cracked-machine/PWMGEN/HW/PWMGEN/DOCS/PWMGEN.pdf

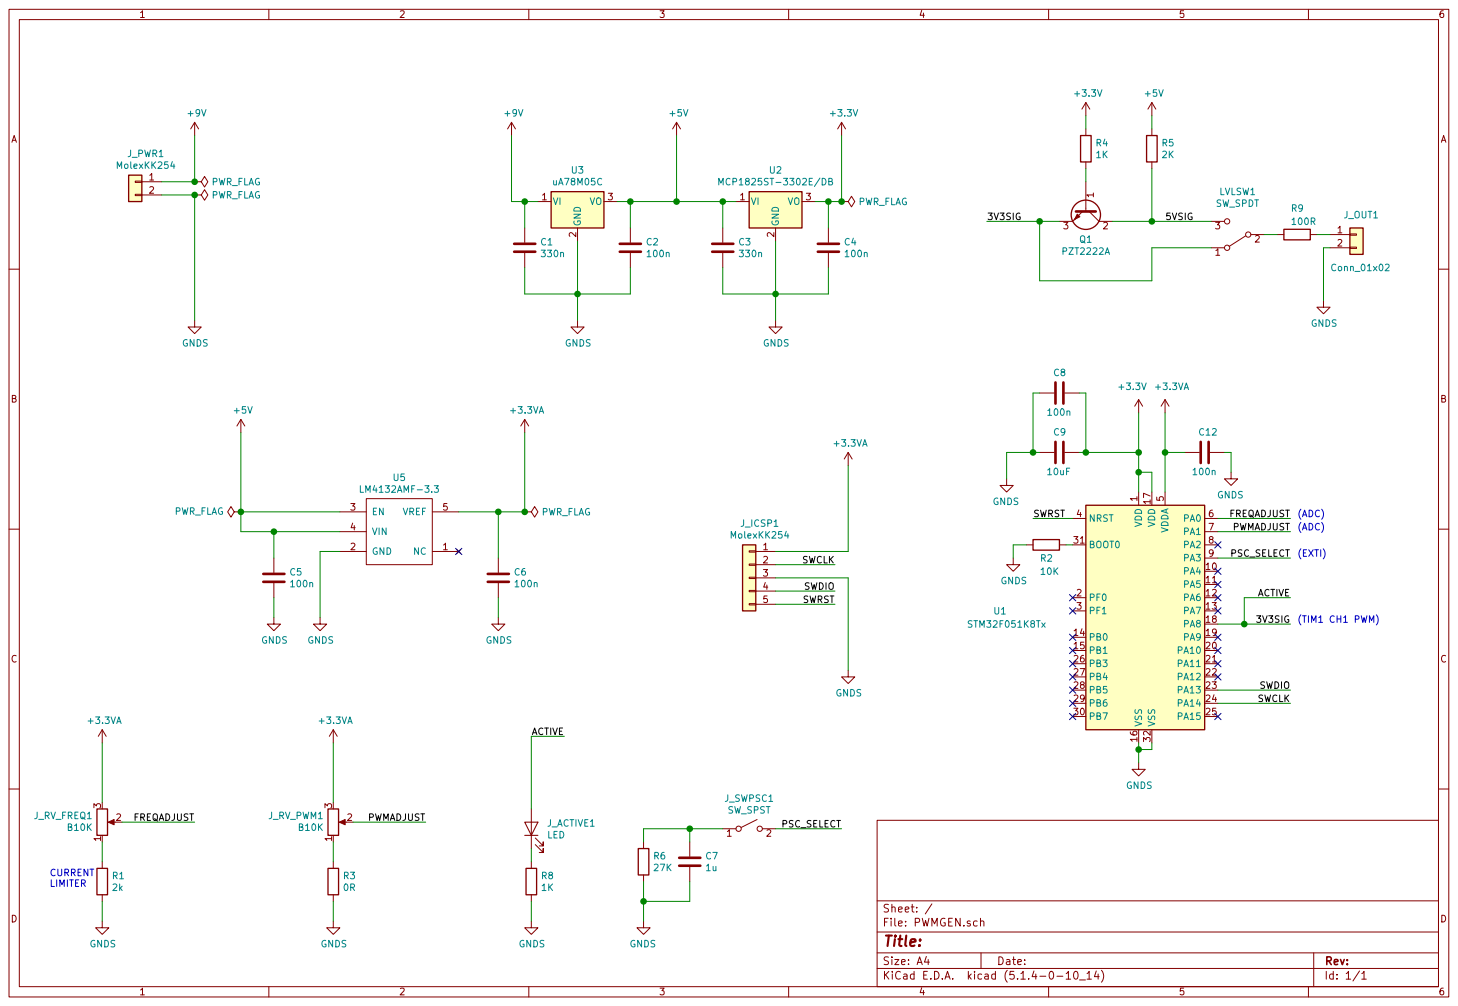
[picture p1: page 1]

Id: 1/1 Title: File: PWMGEN.sch Sheet: /
