cracked-machine/PWMGEN/HW/PWMGEN/PWMGEN.kicad_pcb

## KiCad design HW/PWMGEN/PWMGEN.kicad_pcb (2019-10-10)

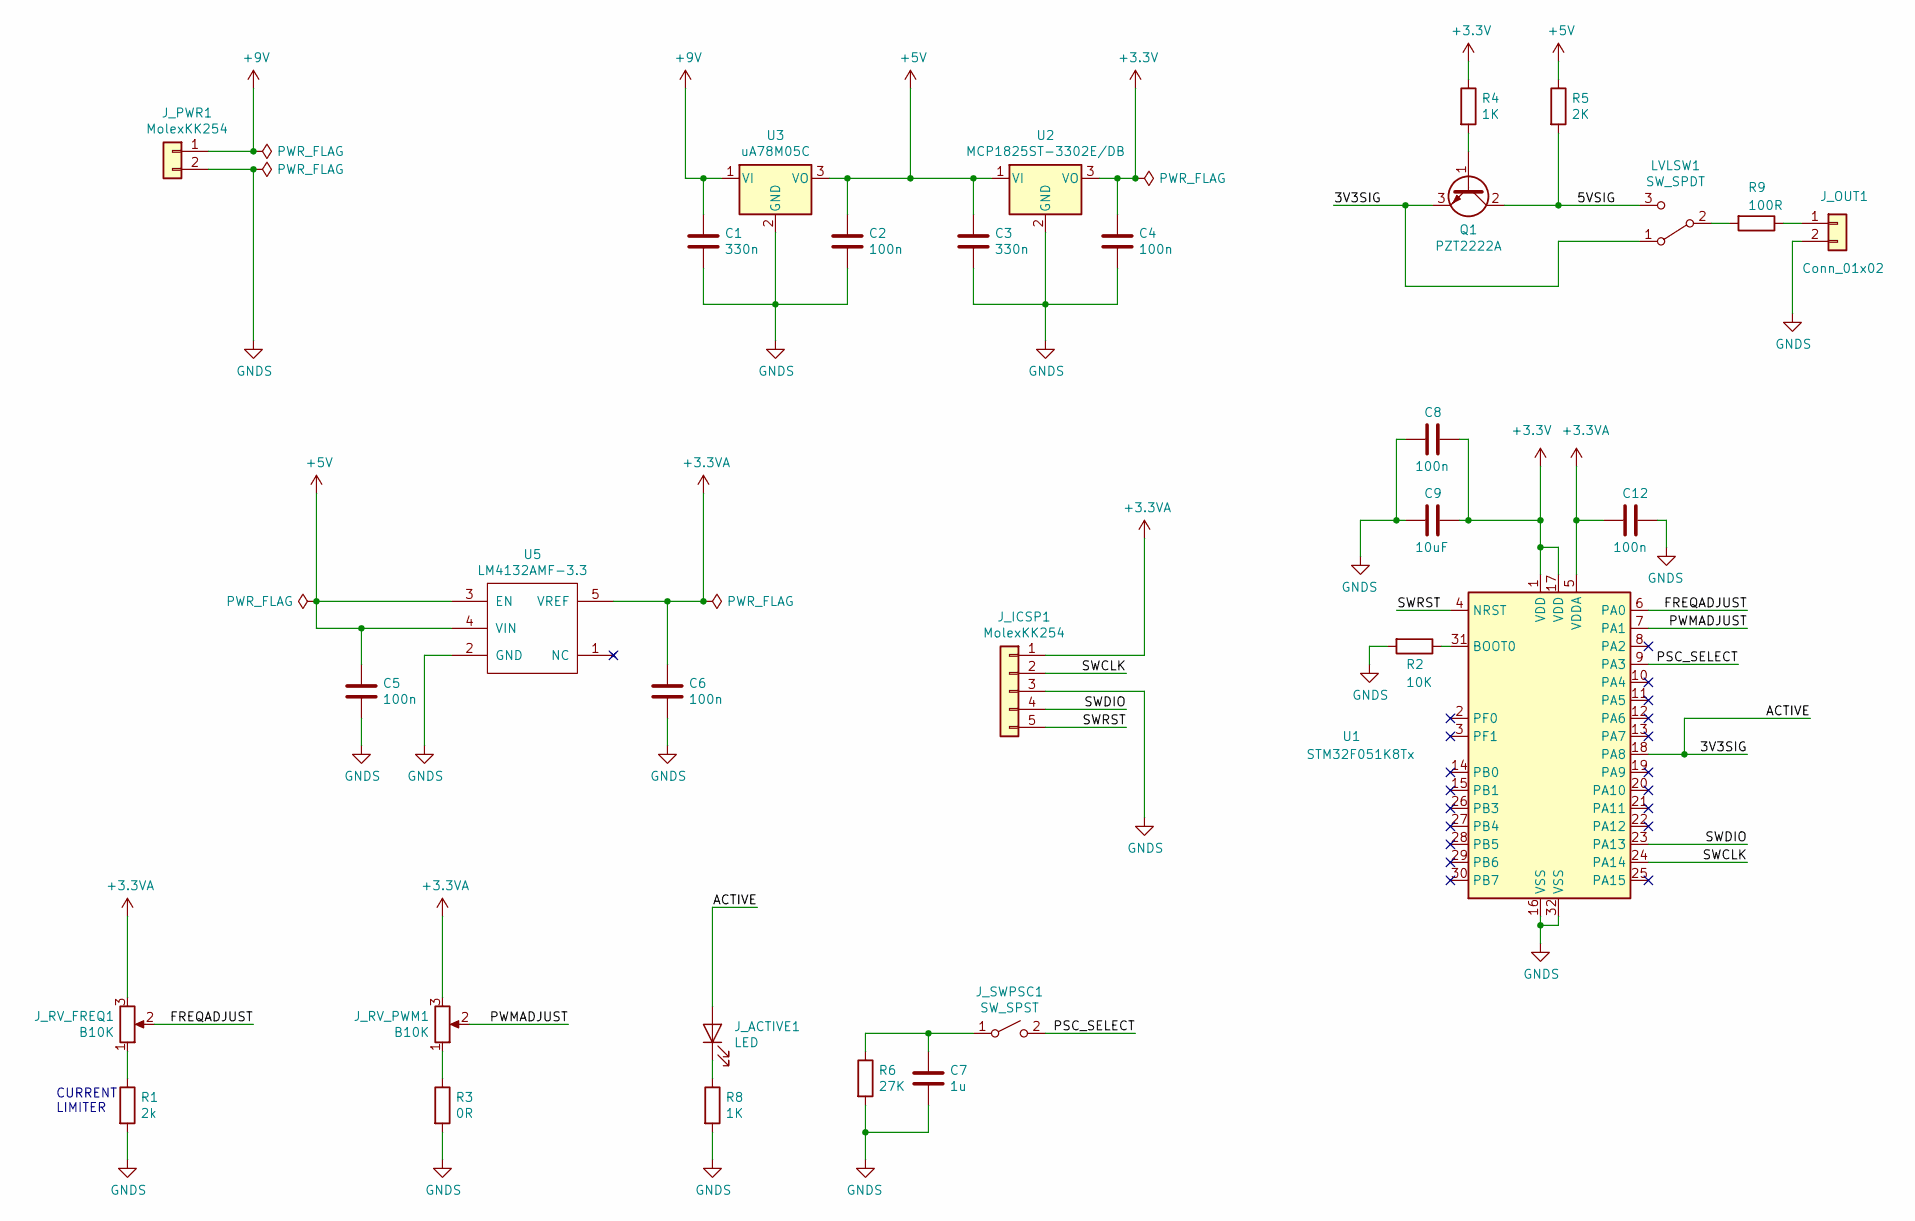
[picture p2: schematic PWMGEN.sch]

Parts:
C1, C3: 330n; C_1206_3216Metric_Pad1.42x1.75mm_HandSolder
C2, C4, C5, C6, C8, C12: 100n; C_1206_3216Metric_Pad1.42x1.75mm_HandSolder
C7: 1u; C_1206_3216Metric_Pad1.42x1.75mm_HandSolder
C9: 10uF; C_1206_3216Metric_Pad1.42x1.75mm_HandSolder
J_ACTIVE1: LED; PinHeader_1x02_P2.54mm_Vertical
J_ICSP1: MolexKK254; PinHeader_1x05_P2.54mm_Vertical
J_OUT1: Conn_01x02; PinHeader_1x02_P2.54mm_Vertical
J_PWR1: MolexKK254; PinHeader_1x02_P2.54mm_Vertical
J_RV_FREQ1: B10K; PinHeader_1x03_P2.54mm_Vertical
J_RV_PWM1: B10K; PinHeader_1x03_P2.54mm_Vertical
J_SWPSC1: SW_SPST; PinHeader_1x02_P2.54mm_Vertical
LVLSW1: SW_SPDT; PinHeader_1x03_P2.54mm_Vertical
Q1: PZT2222A; SOT-223
R1: 2k; R_1206_3216Metric_Pad1.42x1.75mm_HandSolder
R2: 10K; R_1206_3216Metric_Pad1.42x1.75mm_HandSolder
R3: 0R; R_1206_3216Metric_Pad1.42x1.75mm_HandSolder
R4, R8: 1K; R_1206_3216Metric_Pad1.42x1.75mm_HandSolder
R5: 2K; R_1206_3216Metric_Pad1.42x1.75mm_HandSolder
R6: 27K; R_1206_3216Metric_Pad1.42x1.75mm_HandSolder
R9: 100R; R_1206_3216Metric_Pad1.42x1.75mm_HandSolder
U1: STM32F051K8Tx; LQFP-32_7x7mm_P0.8mm
U2: MCP1825ST-3302E/DB; SOT-223-3_TabPin2
U3: uA78M05C; SOT-223-3_TabPin2
U5: LM4132AMF-3.3; SOT-23-5_HandSoldering

Connections:
+3.3VA: C6.1, C12.2, J_ICSP1.1, J_RV_FREQ1.3, J_RV_PWM1.3, U1.5 (VDDA), U5.5 (VREF)
+3V3: C4.1, C8.1, C9.1, R4.1, U1.1 (VDD), U1.17 (VDD), U2.3 (VO)
+5V: C2.1, C3.1, C5.1, R5.1, U2.1 (VI), U3.3 (VO), U5.3 (EN), U5.4 (VIN)
+9V: C1.1, J_PWR1.1, U3.1 (VI)
/3V3SIG: J_ACTIVE1.2 (A), LVLSW1.1 (A), Q1.3 (E), U1.18 (PA8)
/5VSIG: LVLSW1.3 (C), Q1.2 (C), R5.2
/FREQADJUST: J_RV_FREQ1.2, U1.6 (PA0)
/PSC_SELECT: J_SWPSC1.2 (B), U1.9 (PA3)
/PWMADJUST: J_RV_PWM1.2, U1.7 (PA1)
/SWCLK: J_ICSP1.2, U1.24 (PA14)
/SWDIO: J_ICSP1.4, U1.23 (PA13)
/SWRST: J_ICSP1.5, U1.4 (NRST)
GNDS: C1.2, C2.2, C3.2, C4.2, C5.2, C6.2, C7.2, C8.2, C9.2, C12.1, J_ICSP1.3, J_OUT1.2, J_PWR1.2, R1.2, R2.2, R3.2, R6.2, R8.2, U1.16 (VSS), U1.32 (VSS), U2.2 (GND), U3.2 (GND), U5.2 (GND)
unnamed: C7.1, J_SWPSC1.1 (A), R6.1
unnamed: J_ACTIVE1.1 (K), R8.1
unnamed: J_OUT1.1, R9.1
unnamed: J_RV_FREQ1.1, R1.1
unnamed: J_RV_PWM1.1, R3.1
unnamed: LVLSW1.2 (B), R9.2
unnamed: Q1.1 (B), R4.2
unnamed: R2.1, U1.31 (BOOT0)

Notes on the sheet:
CURRENT LIMITER

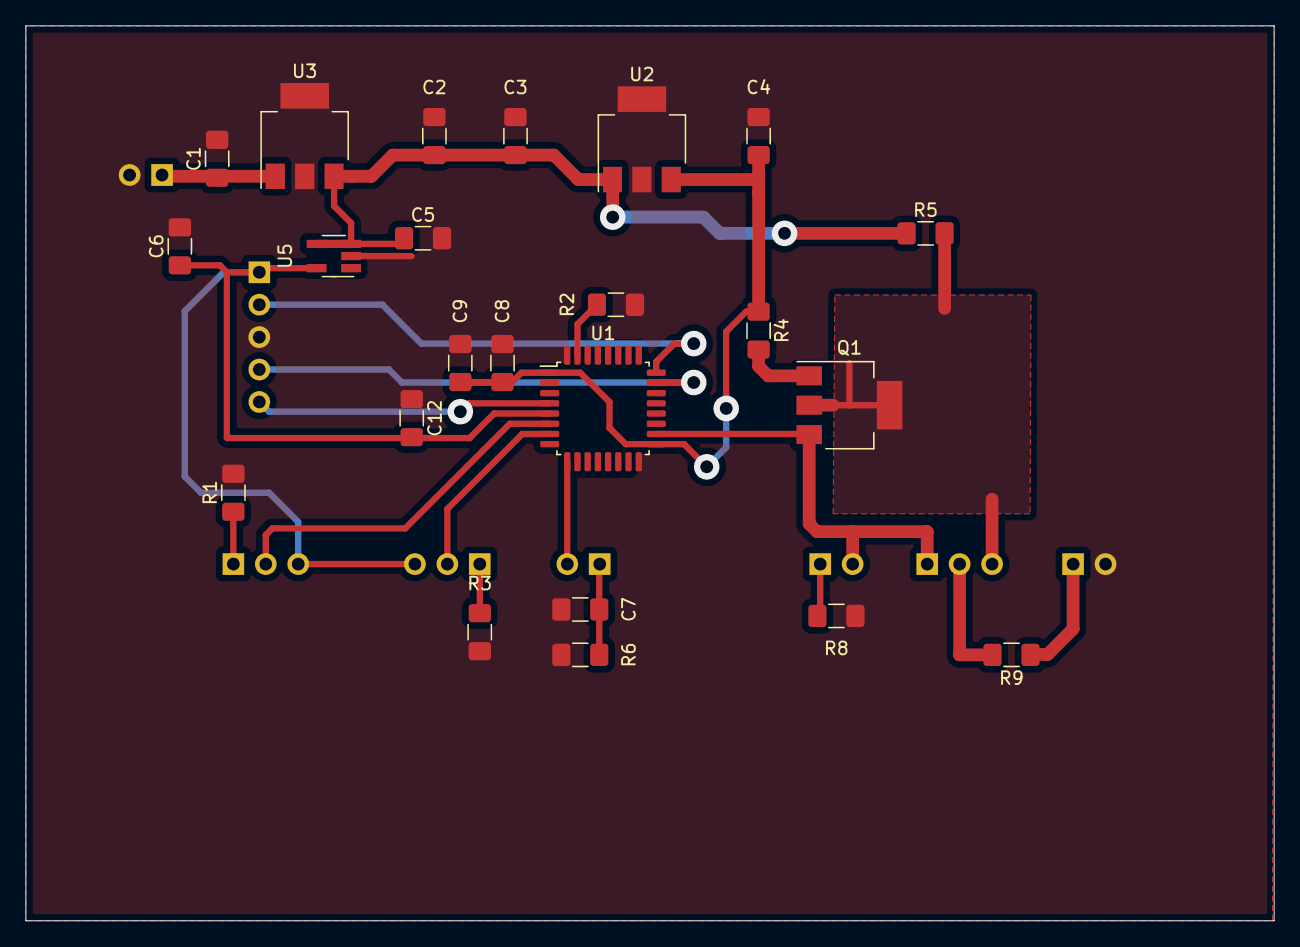
[picture p3: board PWMGEN.kicad_pcb from above]

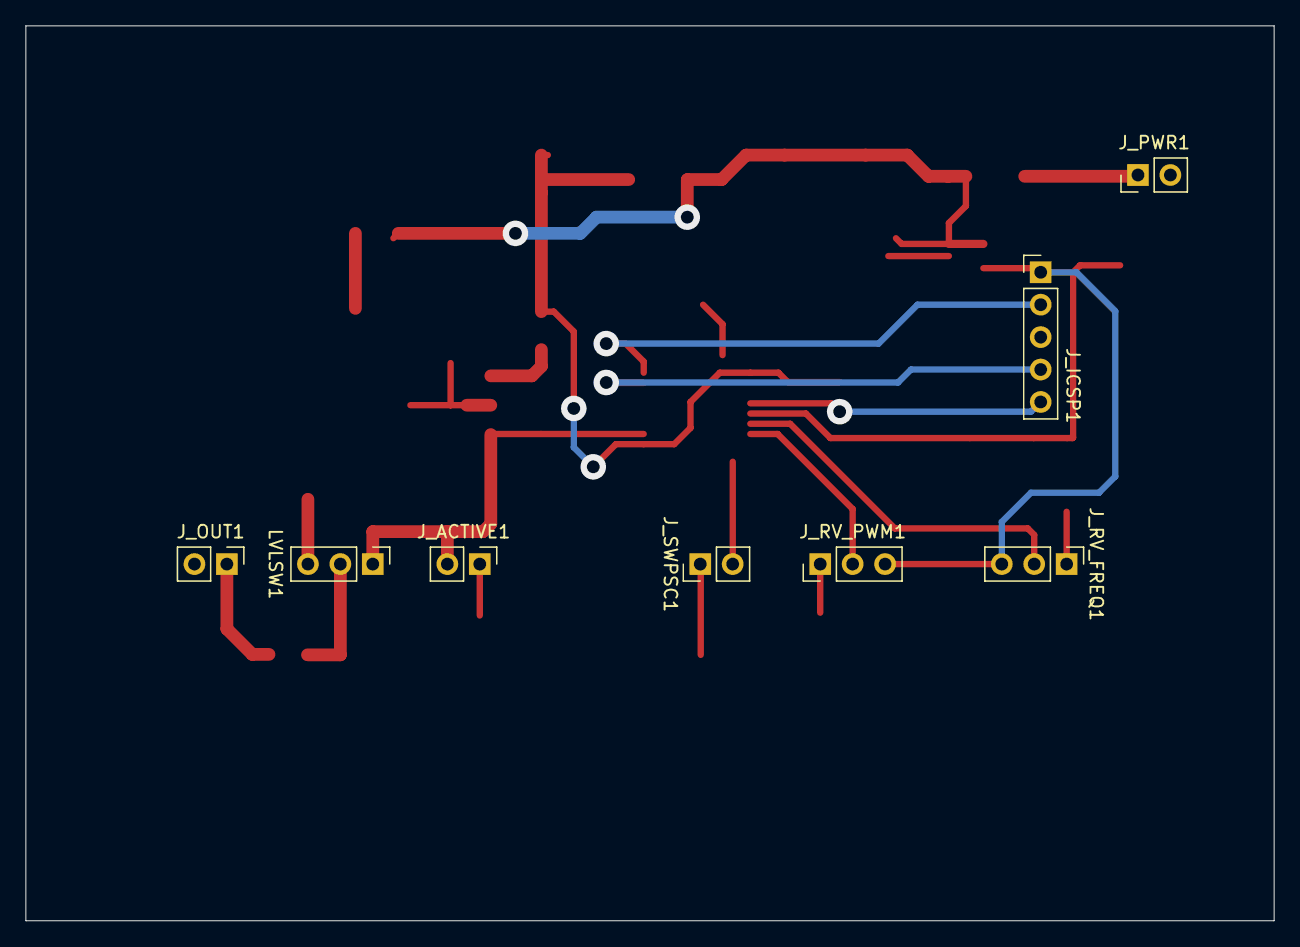
[picture p4: board PWMGEN.kicad_pcb from below]

Board: 2 copper layers, 97.8 x 70.1 mm, 31 parts (8 on the bottom side), 21 nets.
