cracked-machine/PWMGEN/SW/PWMGEN_STM32F051_LL/Src/main.c

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

/* Includes ------------------------------------------------------------------*/
#include "main.h"
#include "adc.h"
#include "dma.h"
#include "tim.h"
#include "gpio.h"


/* USER CODE BEGIN PV */
uint32_t input[SAMPLE_RESOLUTION] = {0};

uint32_t lastdebouncetime = 0;
uint32_t maxdebouncedelay = 500;

/* USER CODE END PV */

void SystemClock_Config(void);
/**
  * @brief  The application entry point.
  * @retval int
  */
int main(void)
{
  

  /* MCU Configuration--------------------------------------------------------*/

  /* Reset of all peripherals, Initializes the Flash interface and the Systick. */
  HAL_Init();

  /* Configure the system clock */
  SystemClock_Config();

  /* Initialize all configured peripherals */
  MX_GPIO_Init();
  MX_DMA_Init();
  MX_TIM1_Init();
  MX_ADC_Init();
  MX_TIM17_Init();
  MX_TIM16_Init();
  /* USER CODE BEGIN 2 */

/*  LL_ADC_StartCalibration(ADC1);
  while(LL_ADC_IsCalibrationOnGoing(ADC1))
  {
	  // wait for calibration
  }

  DMA1_Channel1->CCR = DMA_CCR_EN;
  DMA1_Channel1->CNDTR = SAMPLE_RESOLUTION;
  DMA1_Channel1->CMAR = (uint32_t)input;
  DMA1_Channel1->CPAR = ADC1->DR;

  ADC1->CFGR1 |= ADC_CFGR1_DMAEN;
  ADC1->CR = ADC_CR_ADEN;
  ADC1->CR = ADC_CR_ADSTART;
*/

  HAL_ADCEx_Calibration_Start(&hadc);
  HAL_ADC_Start_DMA(&hadc, input, SAMPLE_RESOLUTION);


  LL_TIM_CC_EnableChannel(TIM1, LL_TIM_CHANNEL_CH1);
  LL_TIM_EnableCounter(TIM1);
  LL_TIM_EnableAutomaticOutput(TIM1);



  LL_TIM_EnableCounter(TIM16);
  LL_TIM_EnableIT_UPDATE(TIM16);

  LL_TIM_EnableCounter(TIM17);
  LL_TIM_EnableIT_UPDATE(TIM17);

  /* USER CODE END 2 */

  /* Infinite loop */
  /* USER CODE BEGIN WHILE */
  while (1)
  {
	  TIM1->CCR1 = 8;
	  LL_mDelay(10);
    /* USER CODE END WHILE */

    /* USER CODE BEGIN 3 */
  }
  /* USER CODE END 3 */
}

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
