cracked-machine/PWMGEN/SW/PWMGEN_STM32F051_LL/PWMGEN_STM32F051_LL.ioc

Mcu.UserName=STM32F051K8Tx
PA0.Signal=ADC_IN0
PA1.Signal=ADC_IN1
PA13.Signal=SYS_SWDIO
PA14.Signal=SYS_SWCLK
PA3.Signal=GPXTI3
PA8.Signal=S_TIM1_CH1
