cracked-machine/PWMGEN/(commit log)

2019-10-04 updated layout
    [PWMGEN.kicad_pcb, PWMGEN.sch]
2019-10-06 updated MCU, layout, sw
    - Changed from STM32L011D4 to STM32F051K8
    [PWMGEN.kicad_pcb, PWMGEN.sch]
2019-10-10 updated sw
    [PWMGEN.kicad_pcb]
2019-10-11 updated sw
    - Implemented timers using LL
    - ADC/DMA using HAL
2019-12-01 updated schematic docs
